Alexeyj4/mpntest/KiKad_MPNtest/MPNtest.kicad_pcb

## KiCad design KiKad_MPNtest/MPNtest.kicad_pcb (2022-12-09)

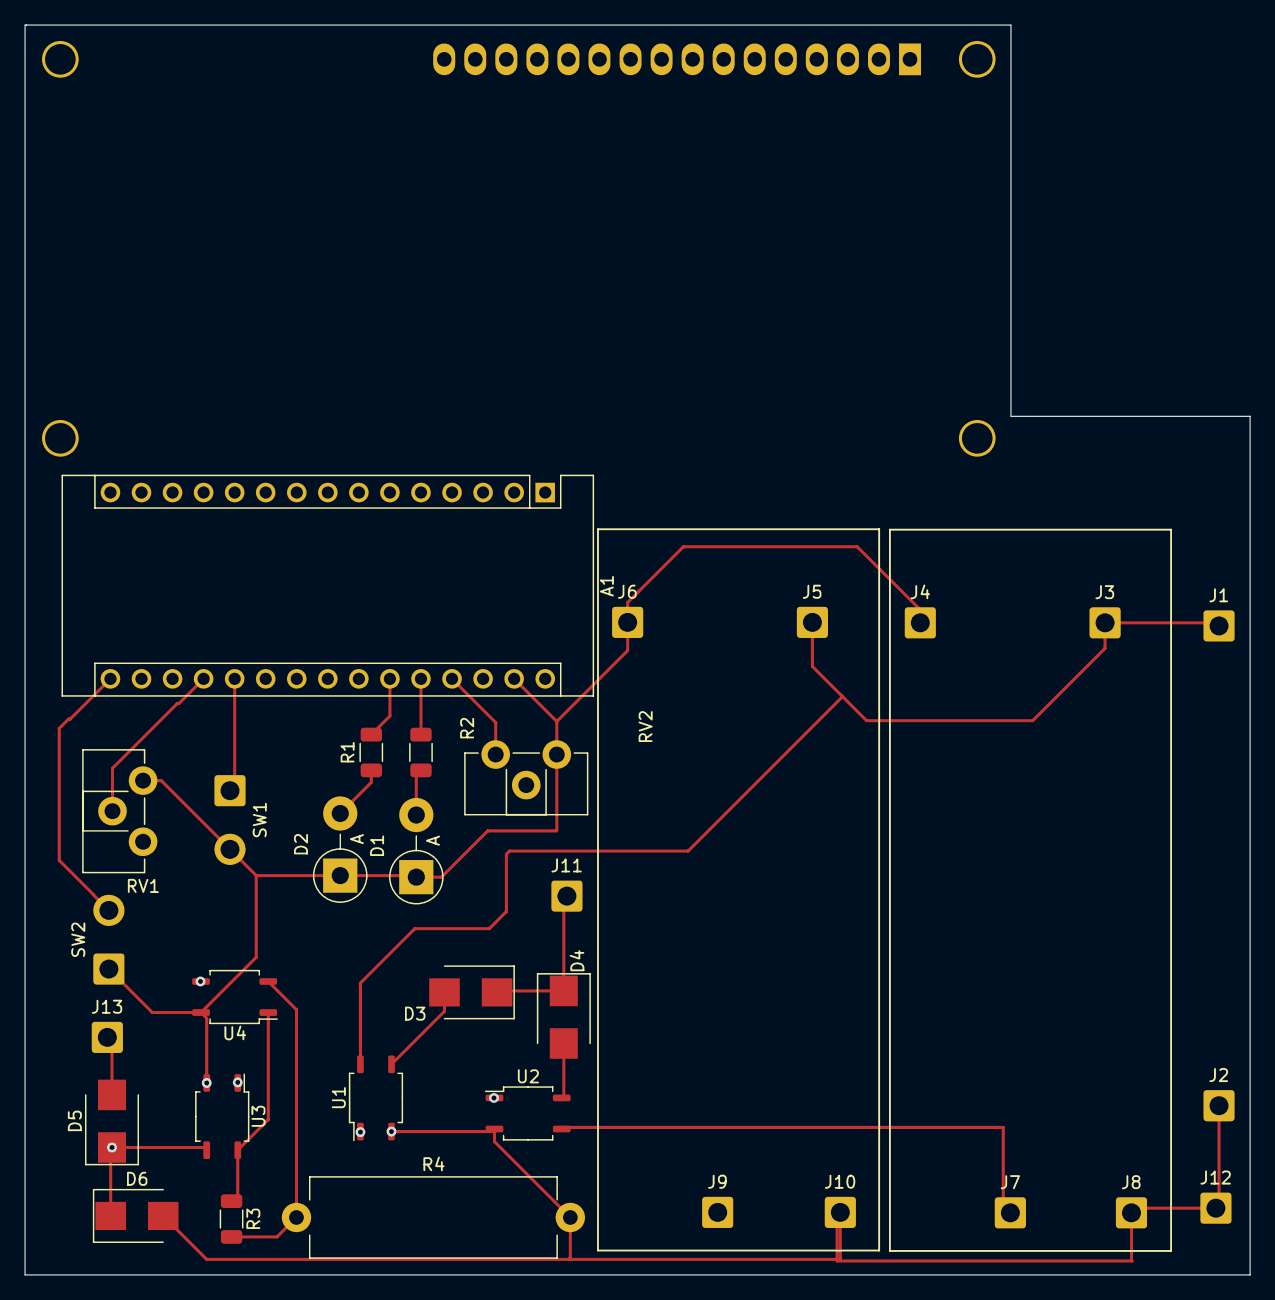
[picture p1: board MPNtest.kicad_pcb from above]

Board: 6 copper layers, 100.2 x 102.2 mm, 33 parts (1 on the bottom side), 30 nets.

Parts:
A1: Arduino_Nano_v2.x; Arduino_Nano
D1: green(ok); D_5W_P5.08mm_Vertical_AnodeUp
D2: red(not ok); D_5W_P5.08mm_Vertical_AnodeUp
D3, D4, D5: 10BQ060; D_SMB
D6: 1N4746A (18V) x20pcs; D_SMB
DS1: WC1602A
J1: MeanWell +48V out; SolderWire-0.75sqmm_1x01_D1.25mm_OD2.3mm
J2: MeanWell GND out; SolderWire-0.75sqmm_1x01_D1.25mm_OD2.3mm
J3: MP55x9V +48V in; SolderWire-0.75sqmm_1x01_D1.25mm_OD2.3mm
J4: MP55x9V GND in; SolderWire-0.75sqmm_1x01_D1.25mm_OD2.3mm
J5: MP55xVDD +48V in; SolderWire-0.75sqmm_1x01_D1.25mm_OD2.3mm
J6: MP55xVDD GND in; SolderWire-0.75sqmm_1x01_D1.25mm_OD2.3mm
J7: MP55x9V +9V out; SolderWire-0.75sqmm_1x01_D1.25mm_OD2.3mm
J8: MP55x9V GND out; SolderWire-0.75sqmm_1x01_D1.25mm_OD2.3mm
J9: MP55xVDD +9V out; SolderWire-0.75sqmm_1x01_D1.25mm_OD2.3mm
J10: MP55xVDD GND out; SolderWire-0.75sqmm_1x01_D1.25mm_OD2.3mm
J11: MPN_test +Vin; SolderWire-0.75sqmm_1x01_D1.25mm_OD2.3mm
J12: MPN_test GND; SolderWire-0.75sqmm_1x01_D1.25mm_OD2.3mm
J13: MPN_test +Vout; SolderWire-0.75sqmm_1x01_D1.25mm_OD2.3mm
R1, R2: 3 кОм; R_1206_3216Metric
R3: 2 Ом; R_1206_3216Metric
R4: 100 Ом 2Вт; R_Axial_Power_L20.0mm_W6.4mm_P22.40mm
RV1: 22 кОм Uout_meas_cal; Potentiometer_ACP_CA9-H2,5_Horizontal
RV2: 2,2 кОм LCD_contrast; Potentiometer_ACP_CA9-H2,5_Horizontal
SW1: 6.3V / 5V switch; SolderWire-0.75sqmm_1x02_P4.8mm_D1.25mm_OD2.3mm
SW2: Start; SolderWire-0.75sqmm_1x02_P4.8mm_D1.25mm_OD2.3mm
U1, U2, U3, U4: CPC1030N; SOP-4_3.8x4.1mm_P2.54mm

Connections:
/HV_on: A1.24 (A5), U1.1
/LCD_D4: A1.12 (D9), DS1.11 (D4)
/LCD_D5: A1.13 (D10), DS1.12 (D5)
/LCD_D6: A1.14 (D11), DS1.13 (D6)
/LCD_D7: A1.15 (D12), DS1.14 (D7)
/LCD_E: A1.11 (D8), DS1.6 (E)
/LCD_RS: A1.10 (D7), DS1.4 (RS)
/LV_on: A1.23 (A4), U2.1
/VDD: A1.30 (VIN), J9.1
/load_on: A1.21 (A2), U3.1
/load_sens: A1.22 (A3), U4.3
GND: A1.4 (GND), A1.29 (GND), D1.1 (K), D2.1 (K), D6.2 (A), DS1.1 (VSS), DS1.5 (R/W), DS1.16 (LED(-)), J2.1, J4.1, J6.1, J8.1, J10.1, J12.1, R4.2, RV1.3, RV2.1, SW1.2 (B), SW2.1, U1.2, U2.2, U3.2, U4.4
unnamed: A1.16 (D13), SW2.2
unnamed: A1.19 (A0), RV1.2
unnamed: A1.20 (A1), SW1.1 (A)
unnamed: A1.25 (A6), R1.2
unnamed: A1.26 (A7), R2.2
unnamed: A1.27 (+5V), DS1.2 (VDD), DS1.15 (LED(+)), RV2.3
unnamed: D1.2 (A), R2.1
unnamed: D2.2 (A), R1.1
unnamed: D3.1 (K), D4.1 (K), J11.1
unnamed: D3.2 (A), U1.3
unnamed: D4.2 (A), U2.4
unnamed: D5.1 (K), D6.1 (K), RV1.1, U3.3
unnamed: D5.2 (A), J13.1
unnamed: DS1.3 (VO), RV2.2
unnamed: J1.1, J3.1, J5.1, U1.4
unnamed: J7.1, U2.3
unnamed: R3.1, U3.4, U4.1
unnamed: R3.2, R4.1, U4.2
